ryangadz/Altmill-Mods/README.md

# Altmill-Mods
Custom parts for Sienci Labs Altmill CNC Router
