ryangadz/Altmill-Mods/Touchscreen Mount/README.md

# Front Pivoting Touchscreen Mount

|  folded  |  extended |
| --- | --- |
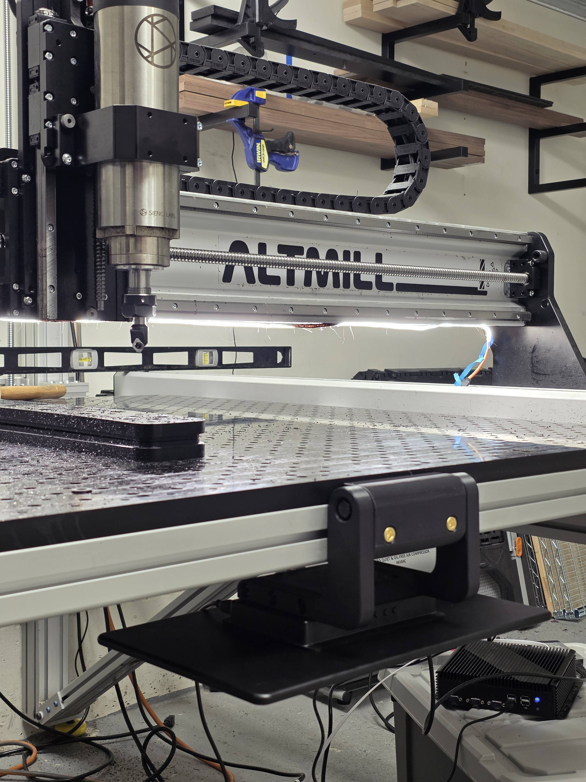
[picture p7: Touchscreen Mount/Folded.jpg]
folded position
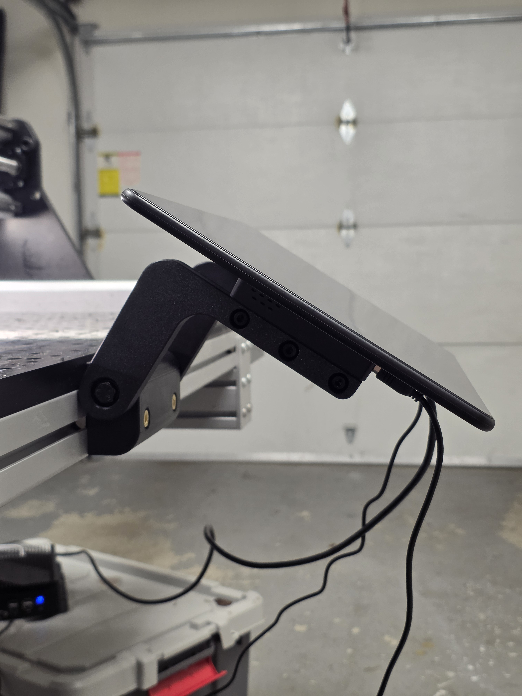
[picture p8: Touchscreen Mount/Extended.jpg]
|  |   |

## Parts Needed
1. 1x M8 150mm bolt - [Amazon](https://www.amazon.com/dp/B0FFXKZLWW?ref=fed_asin_title&th=1).
2. 6x brass heatset M6 nuts - [Amazon](https://www.amazon.com/Kadrick-Threaded-Inserts-Printing-Components/dp/B0D5QK7YGQ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)
3. 6x M6 20mm bolts - [Amazon](https://www.amazon.com/dp/B0D78N7H18?ref=fed_asin_title&th=1)
4. 4x M4 12mm bolts - [Amazon](https://www.amazon.com/M4-0-70-Button-Stainless-Fullerkreg-Plastic/dp/B07H17YKW1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)
5. 2x M8 40mm bolts - [Amazon](https://www.amazon.com/M8-1-25-Socket-Screws-Stainless-Machine/dp/B07GCKHMBH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)
6. 2x Nylon Washers (M8-M12 will all work) but I used M12 - [Amazon](https://www.amazon.com/HELIFOUNER-Washers-Plastic-Diameter-Thickness/dp/B0BNBNSRQP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)
7. 75mm VESA mounted touchscreen - [Amazon](https://www.amazon.com/dp/B0DB7G1TW4?ref=fed_asin_title)

## Printing Tips

- Print with your favorite filament (ASA used here). 
- Use 5 wall loops, 8 top and bottom layers, 30% infill. 
- Arm needs to be mirrored for the second one. 

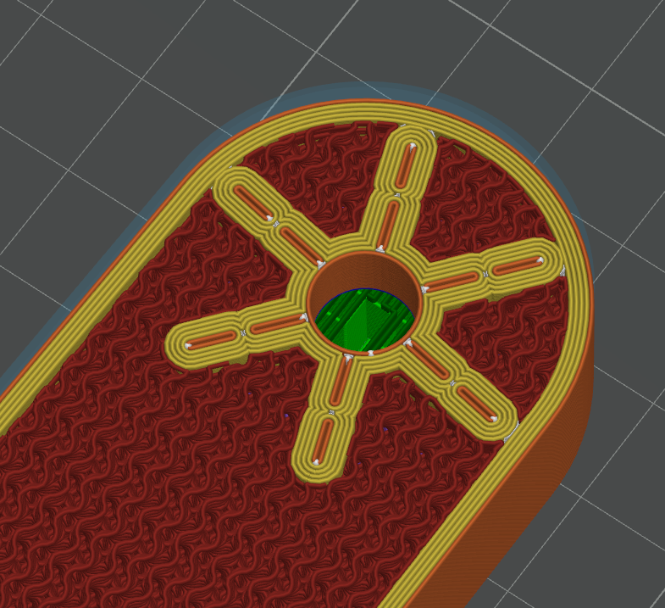
[picture p9: Touchscreen Mount/PivotReinforcement.png]


## Altmill Aluminum Extrusion Issues

The Altmill uses almost standard 45mm extrusions but I have yet to find any nuts that can be inserted from the front. To add M8 nuts in the extrusion you'll ether have to widen the slot in (preferbally in a hidden location like behind the mount) or dissamble one side of the front extrusion.
