ryangadz/Altmill-Mods/Folding Wall Mount/Prints/Motor Driver Mount.3mf

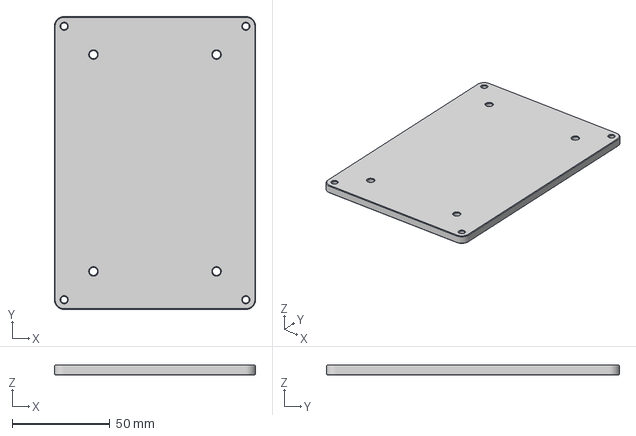
[picture p10: CAD file, 2026-02-03]
Folding Wall Mount/Prints/Motor Driver Mount.3mf
103.0 x 150.0 x 5.00 mm
