ryangadz/Altmill-Mods/Touchscreen Mount/Touchscreen Mount Arm.3mf

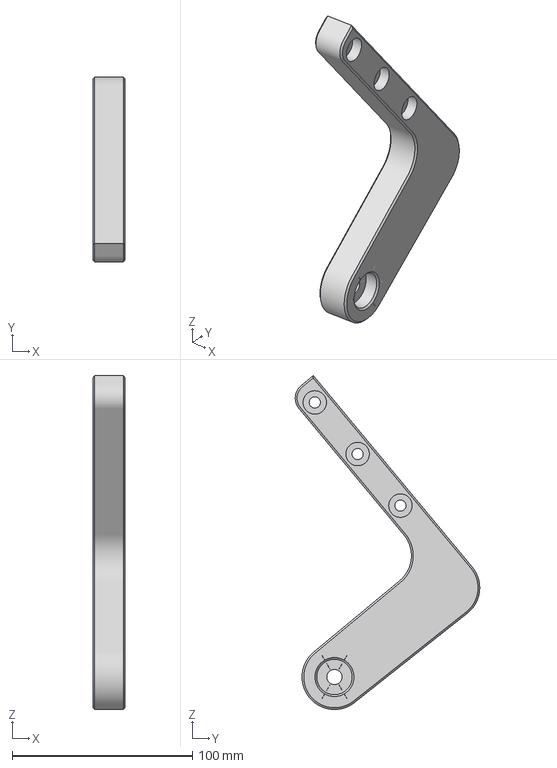
[picture p11: CAD file, 2026-01-28]
Touchscreen Mount/Touchscreen Mount Arm.3mf
18.0 x 102.3 x 185.1 mm
