ryangadz/Altmill-Mods/Folding Wall Mount/Prints/Power Supply Mounting Bracket.3mf

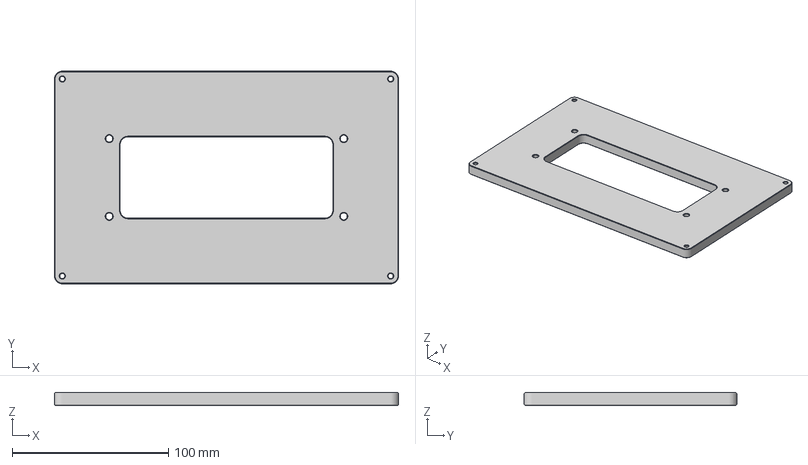
[picture p12: CAD file, 2026-02-03]
Folding Wall Mount/Prints/Power Supply Mounting Bracket.3mf
220.0 x 136.0 x 8.00 mm
