ryangadz/Altmill-Mods/Touchscreen Mount/Touchscreen Mount VESA.3mf

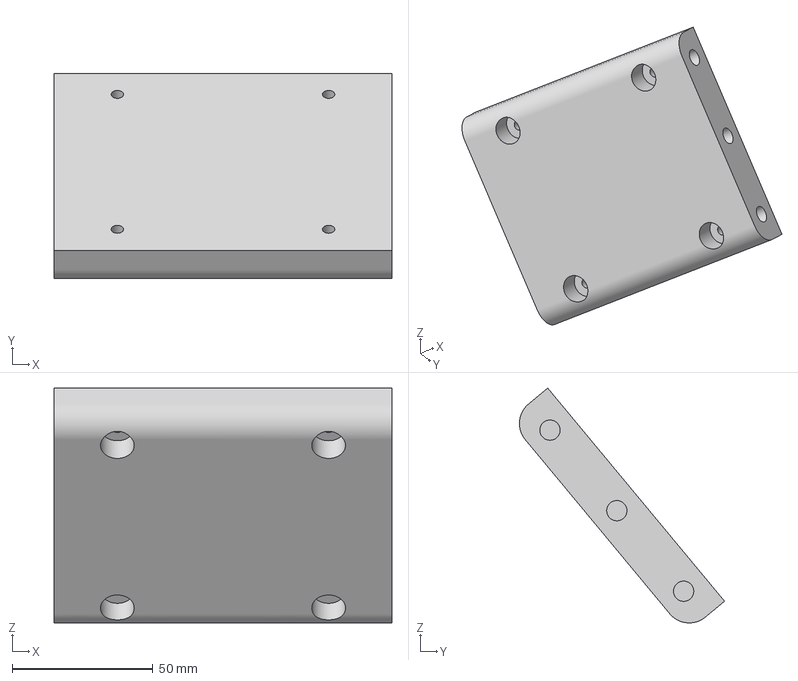
[picture p13: CAD file, 2026-01-28]
Touchscreen Mount/Touchscreen Mount VESA.3mf
120.0 x 72.8 x 83.4 mm
