ryangadz/Altmill-Mods/Folding Wall Mount/Prints/ESP32 Mount for Enclosure.3mf

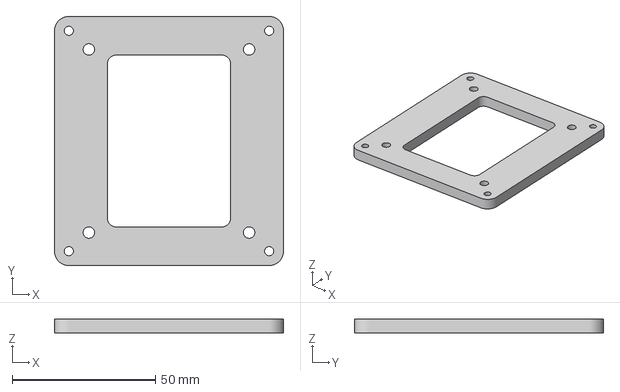
[picture p14: CAD file, 2026-01-30]
Folding Wall Mount/Prints/ESP32 Mount for Enclosure.3mf
80.0 x 87.0 x 5.00 mm
