ryangadz/Altmill-Mods/Touchscreen Mount/Touchscreen Mount Base.3mf

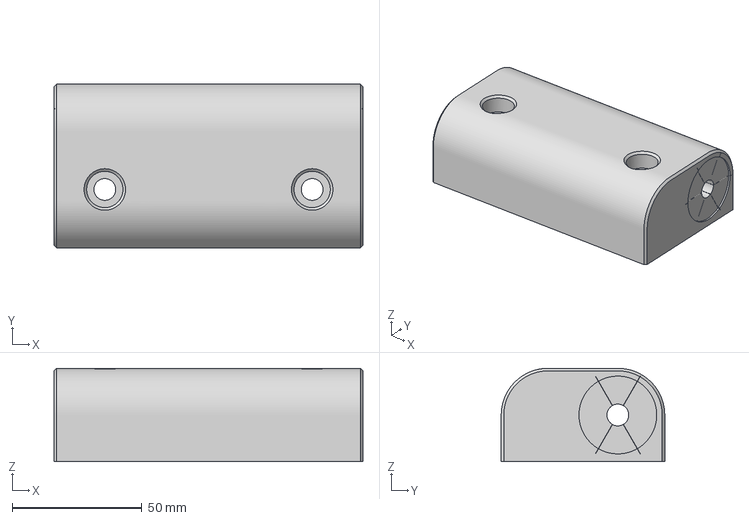
[picture p15: CAD file, 2026-01-28]
Touchscreen Mount/Touchscreen Mount Base.3mf
119.2 x 63.1 x 36.0 mm
