ryangadz/Altmill-Mods/(list of files, cad)

Other CAD files:
Touchscreen Mount/Touchscreen Mount.f3d
