ryangadz/Altmill-Mods/Folding Wall Mount/Software/StepperWebControl/secrets_template.h

// secrets_template.h - Rename this to secrets.h and fill in your info
#define SECRET_SSID "REPLACEME"
#define SECRET_PASS "REPLACEME"
#define SECRET_USER "admin"
#define SECRET_WEB_PASS "password123"
