ryangadz/Altmill-Mods/(commit log)

2026-01-28 Monitor Mount files and directions
    [Touchscreen Mount Arm.3mf, Touchscreen Mount Base.3mf, Touchscreen Mount VESA.3mf]
2026-01-28 Touchscreen Mount Fusion File
    [Touchscreen Mount.f3d]
2026-01-28 monitor mount extrusion notes
2026-01-28 touchscreen mount m8 20mm screws added
2026-01-28 touchscreen mount washers
2026-01-29 Initial WIP web stepper control
2026-01-30 esp32 mount added
    [ESP32 Mount for Enclosure.3mf]
2026-02-03 completed Altmill wall mount
    [Motor Driver Mount.3mf, Power Supply Mounting Bracket.3mf]
2026-10-13 Z-Axis Brake: power-off brake plan, fit check, interference + bracket fix (2026-10-12)
